nuksimon/Sequencer/README.md

Sequencer Wall Interactive Music Project
====

http://sequencedlife.wordpress.com/

a tactile music installation built with an arduino. 
step sequencer interface encourages music creation regardless of skill.
