nuksimon/Sequencer/Schematics/Sequencer Block Diagram.pptx

Ableton
(sound)

Arduino
(brains)

Sequencer
(lights & buttons)

LED Brightness

Audio
Processing

MIDI

State
Machine

LEDs
Buttons

Button Press

## Slide 2

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
