nuksimon/Sequencer/Design/UI Design.xlsx

Sheet: UI
 |  | Pages
 |  | 1 | 2 | 3 | 4 | 5 | 6 | 7 | 8
Channels | 1
 | 2
 | 3
 | 4 |  |  |  | Grid
 | 5
 | 6
 | 7
 | 8

Sheet: Grid
 |  | Page
 | Channel | 0 | 1 | 2 | 3 | 4 | 5 | 6 | 7
Instrument #1 | 0 | Inst.1 /p1 | Inst.1 /p2 | Inst.1 /p3 | Inst.1 /p4 | Inst.1 /p5 | Inst.1 /p6 | Inst.1 /p7 | Inst.1 /p8
Instrument #2 | 1 | Inst.2 /p1 | Inst.2 /p2 | Inst.2 /p3 | Inst.2 /p4 | Inst.2 /p5 | Inst.2 /p6 | Inst.2 /p7 | Inst.2 /p8
Instrument #3 | 2 | Inst.3 /p1 | Inst.3 /p2 | Inst.3 /p3 | Inst.3 /p4 | Inst.3 /p5 | Inst.3 /p6 | Inst.3 /p7 | Inst.3 /p8
Instrument #4 | 3 | Inst.4 /p1 | Inst.4 /p2 | Inst.4 /p3 | Inst.4 /p4 | Inst.4 /p5 | Inst.4 /p6 | Inst.4 /p7 | Inst.4 /p8
 | 4
Menu | 5 | Tempo | Steps | Prob |  |  |  |  | Clear
Freeze/Follow | 6 | Freeze/Follow
Play/Pause | 7 | Play/Pause
Function | Description
Instrument #1 | Sends Midi to Instrument#1
Instrument #2 | Sends Midi to Instrument#2
Instrument #3 | Sends Midi to Instrument#3
Instrument #4 | Sends Midi to Instrument#4
Tempo | Sets the global tempo, 1 to 64 (slow to fast)
Steps | Sets the number of steps to loop through on this sequencer, 1 to 64
Prob | Sets the probability of moving to a different sequencer, 1 to 8 (low to high chance)
Clear | Clears page/instrument/all instruments of what has been programmed
Freeze/Follow | Toggels the Grid to follow the current step as it switches between pages, or to remain stationary
Play/Pause | Global play/pause for the sequencers

Sheet: Arduino Elements
Element | < max | Description
seq_num | 3 | the physical sequencer board
col_num | 10 | button/RGB LED column number. Grid = 1-8, Channel = 0, Page = 9
row_num | 8 | button/RGB LED column number
rgb | 3 | identifies the Red, Green, or Blue element for the LEDs
channel_num | 8 | channel identifier (vertical menu)
page_num | 8 | page identifier (horizontal menu)
state_val | tbd | current state of the LED element
led_col | 16 | LED column number for a given row (i.e. each RGB LED requires 3 columns)
rgb_val | 4095 | 12 bit RGB brightness value for the LED
Array | Description
column_map | static mapping array to find the led_col
colour_map | static mapping array to find the rgb_val for an LED element
active_channel | channel currently being displayed on the specified sequencer
active_page | page currently being displayed on the specified sequencer
state_ctrl | contains the current state of the state machine
