nuksimon/Sequencer/Design/Design Alternatives Parts Pricing.xlsx

Sheet: Parts
 | Part Name | Part Number | Desc | Source | Qty req | Price | #/Price | Cost
 | Button Pad | COM-07835 | 4x4 grid | SparkFun | 5 | 8.96 | 1 | 44.8
 | PCB |  |  |  | 1 | 40 | 1 | 40
Individual RGB | LED Control | MAX7219 |  |  | 4 | 13 | 1 | 52 |  |  | 320 | 16
 | RGB LED | COM-09985 |  | SparkFun | 80 | 59.59 | 100 | 47.672
Mono LED | LED Control | MAX7219 |  |  | 2 | 13 | 1 | 26
 | LED |  |  | SparkFun | 80 | 2.95 | 25 | 9.44
Board RGB? | LED Control | MAX7219 |  |  | 2 | 13 | 1 | 26
 | RGB LED | COM-09985 |  | SparkFun | 80 | 59.59 | 100 | 47.672
8x8 boards
Arduino | Arduino Mega 2560 |  |  | Creatron | 1 | 56.29 | 1 | 56.29
Test | RGB LED Matrix | COM-00683 | 8x8 test matrix | SparkFun | 1 | 29.95 | 1 | 29.95
RGB string | LED Pixel 20mm x bundle of 20 |  |  | bliptronics | 64 | 40.05 | 20 | 128.16
 | no driver required
driver circuit | LED driver | TLC5940 | 16 channel | TI | 2 | 11 | 1 | 22
 | RGB LED |  | common ANODE | SparkFun | 64 | 59.59 | 100 | 38.1376
 | pnp transistor |  |  |  | 8 | 0.3 | 1 | 2.4
 | diodes |  |  |  | 64 | 3 | 10 | 19.2
 | Shift Reg S_to_P | 74HC595 | 8 bit row control |  | 2 | 1.05 | 1 | 2.1 | or 8 bit | 74HC595 |  | 16 bit | 74F673A
 | Shift Reg P_to_S | 74LS165 | 8 bit button col read |  | 2 | 1.2 | 1 | 2.4 | or 8 bit | 74LS165 |  | 16 bit | 74F676
 | Button Pad | COM-07835 | 4x4 grid, 3-5mm LEDs | SparkFun | 4 | 8.96 | 1 | 35.84
 | PCB |  |  |  | 1 | 40 | 1 | 40
 | IC Sockets |  |  |  | 4 | 1 | 1 | 4
 |  |  |  |  |  |  | Total | 162.0776
 | or 3 bit MUX?? | 74LS42 | 10 channel mux
Monome 4 8x8
Logic Board |  |  |  |  | 1 | 60 | 1 | 60
Driver |  |  |  |  | 4 | 40 | 1 | 160
Keypad |  |  |  |  | 4 | 120 | 1 | 480
LEDs |  |  |  |  | 256 | 0.2 | 1 | 51.2
 |  |  |  |  |  |  | Total | 751.2

Sheet: IO
 | Sequencer | multiplier | arduino
clock | 1 | 1 | 1
vcc | 1 | 1 | 1
gnd | 1 | 1 | 1
row control | 4 | 1 | 4
col control | 1 | 5 | 5
button | 1 | 5 | 5
Total | 9 |  | 17
