nuksimon/Sequencer/Schematics/Part List v2.xlsx

Sheet: IO
Component | # I/O ports
LED Driver | 5
button | 3
Vcc | 1
GND | 1
Total | 10

Sheet: BOM
Part Number | Description | Circuit | Schematic# | #/seq | # total | Extra | Req | Have | Need | digi key
R 500Ω | pull down | Button Control | R21-R100 | 80 | 240 | 20 | 260 | 300 | -40
 | 4x4 button Grid | Button Control | SW1-SW80 | 5 | 15 | 1 | 16 | 16 | 0
74HC165 | 8-bit parallel to serial | Button Control | U30-U39 | 10 | 30 | 2 | 32 | 10 | 22 | 0.41
 | DIP Socket 16 | Button Control | U30-U39 | 10 | 30 | 5 | 35 | 11 | 24
TLC5940 | LED Driver | LED Driver | U2-U17 | 16 | 48 | 2 | 50 | 5 | 45 | 3.6
 | DIP Socket 28 | LED Driver | U2-U17 | 16 | 48 | 5 | 53 | 10 | 43
R 2k | I regulator | LED Driver | R2-R17 | 16 | 48 | 5 | 53 |  | 53
 | DB15 | Connector, Arduino Breakout | J1 | 2 | 6 | 4 | 10 | 0 | 10 | 2.61
 | RGB LED - Common Anode | LED Array | L1-L80 | 80 | 240 | 60 | 300 | 300 | 0
?F | Regulator Caps |  | tbd |  | 0 | 5 | 5 | 0 | 5
R 220Ω | MIDI resistor | Arduino Breakout |  |  | 1 | 3 | 4 | 8 | -4
 | MIDI connectors | Arduino Breakout | J4, J5 |  | 2 | 0 | 2 | 2 | 0
 | DB15 Cable | Connector |  | 1 | 3 | 0 | 3 | 0 | 3 | 8
 | Arduino Mega2560 | Arduino |  |  | 1 | 0 | 1 | 1 | 0
 | External RAM | Arduino |  |  | 1 | 0 | 1 | 0 | 1
 | Sequencer PCB | PCB |  | 1 | 3 | 1 | 4 | 0 | 4

Sheet: SparkFun Order
Part Number | Description | Circuit | Schematic# | #/seq | # total | Have | Need | Extra | total | SF # | # units | price/units | total price | order#
 | DIP Socket 16 | Row Driver, Button Control | U1, U4-U5 | 3 | 9 | 0 | 9 | 2 | 11 | PRT-07938 | 1 | 0.45 | 4.95 | 11
TLC5940 | LED Driver | Column Driver | U2-U3 | 2 | 6 | 2 | 4 | 1 | 5 | COM-10136 | 1 | 5.95 | 29.75 | 5
 | DIP Socket 28 | Column Driver | U2-U3 | 2 | 6 | 0 | 6 | 4 | 10 | PRT-07942 | 1 | 0.86 | 8.6 | 10
 | 4x4 button Grid | Button Array | SW1-SW80 | 5 | 15 | 0 | 15 | 1 | 16 | COM-07835 | 1 | 8.96 | 143.36 | 16
74HC165 | 8-bit parallel to serial | Button Control | U4-U5 | 2 | 6 | 0 | 6 | 4 | 10 | COM-09519 | 1 | 1.45 | 14.5 | 10
 |  |  |  |  |  |  |  |  |  |  |  |  | 201.16
 | RGB LED - Common Anode | LED Array | L1-L80 | 80 | 240 | 0 | 240 | 10 | 250 | COM-10819 | 25 | 17.96 | 179.6
 |  |  |  |  |  |  |  | 60 | 300 | Parts Express 100@ $28 | 100 | 28.85 | 86.55 | 3
1N4148 | Diode | Button Array | D1-D80 | 80 | 240 | 0 | 240 | 10 | 250 | COM-08588 | 1 | 0.12 | 30
 |  |  |  |  |  |  |  | 10 | 250 | Parts Express 100@ $28 | 1 | 0.05 | 12.5 | 250
 |  |  |  |  |  |  |  |  |  |  |  |  | 99.05

Sheet: Digi Key Order
Part Number | Description | Circuit | Schematic# | #/seq | # total | Extra | Req | Have | Need | digi key
74HC165 | 8-bit parallel to serial | Button Control | U30-U39 | 10 | 30 | 5 | 35 | 10 | 25 | 0.41
 | DIP Socket 16 | Button Control | U30-U39 | 10 | 30 | 6 | 36 | 11 | 25 | 0.211
TLC5940 | LED Driver | LED Driver | U2-U17 | 16 | 48 | 2 | 50 | 5 | 45 | 3.6
 | DIP Socket 28 | LED Driver | U2-U17 | 16 | 48 | 5 | 53 | 10 | 43 | 0.447
R 2k | I regulator | LED Driver | R2-R17 | 16 | 48 | 5 | 53 |  | 53 | 0.041
 | DB15 | Connector, Arduino Breakout | J1 | 2 | 6 | 2 | 8 | 0 | 8 | 2.72
 | DB15 Cable | Connector |  | 1 | 3 | 0 | 3 | 0 | 3
