nuksimon/Sequencer/Casing/casing hardware.xlsx

Standoff
Digi-Key Part Number | Manufacturer Part Number | Manufacturer | Description | Quantity Available | Factory Stock | Unit Price (CAD) | @ qty | Minimum Quantity | Series | Type | Threaded/Unthreaded | Gender | Diameter - Outside | Thread/Screw/Hole Size | Between Board Height | Length - Overall | Features | Material | Plating | Color
25504K-ND | 25504 | Keystone Electronics | HEX STANDOFF M3 NYLON 18MM | 8120 | 600 | 0.65 | 0 | 1 | - | Hex Standoff | Threaded | Male, Female | 0.197" (5.00mm) Hex | M3 Thread | 0.709" (18.00mm) | 1.024" (26.00mm) | - | Nylon | - | Natural
24340K-ND | 24340 | Keystone Electronics | HEX STANDOFF M3 ALUMINUM 18MM | 135 | 1200 | 0.88 | 0 | 1 | - | Hex Standoff | Threaded | Male, Female | 0.197" (5.00mm) Hex | M3 Thread | 0.709" (18.00mm) | 1.024" (26.00mm) | - | Aluminum | Iridite | Natural
Digi-Key Part Number | Manufacturer Part Number | Manufacturer | Description | Quantity Available | Factory Stock | Unit Price (CAD) | @ qty | Minimum Quantity | Series | Type | Screw Head Type | Drive Type | Features | Thread Size | Head Diameter | Head Height | Length - Below Head | Length - Overall | Material | Plating
29346K-ND | 29346 | Keystone Electronics | MACHINE SCREW PAN SLOTTED M3 | 385 | 600 | 0.24 | 0 | 1 | - | Machine Screw | Pan Head | Slotted | - | M3 | - | - | 0.630" (16.00mm) | - | Nylon | -
29316K-ND | 29316 | Keystone Electronics | MACHINE SCREW PAN SLOTTED M3 | 468 | 900 | 0.48 | 0 | 1 | - | Machine Screw | Pan Head | Slotted | - | M3 | - | - | 0.630" (16.00mm) | - | Steel | Zinc
Item | #/board | all boards | extra | Total |  |  |  |  | 8.541
Standoff | 9 | 27 | 23 | 50 |  |  |  | 10 | 0.219 | 37.48858447
Screw | 9 | 27 | 23 | 50 |  |  |  | 50 | 0.1642 | 8.21
 |  |  |  |  |  |  |  | 10 | 0.505 | 5.05 | 39.98019802
 |  |  |  |  |  |  |  | 50 | 0.4038 | 20.19
