nuksimon/Sequencer/Design/Test Cases.xlsx

# | Result | PCB Pre-Req? | Test Case Name | Test Area | Description | Parameters
1 | Pass | Yes | Arduino->MIDI out | MIDI | Arduino can generate MIDI commands to serial output | Note On, Note Off, single channel
2 | Pass | Yes | Arduino->MIDI->Ableton out | MIDI | Ableton can receive MIDI commands generated by Arduino | Note On, Note Off, multiple channels
3 |  |  | Ableton->MIDI->Arduino in | MIDI | Arduino can receive MIDI commands generated by Ableton | Note On, Note Off, multiple channels
4 | Pass | Yes | Daisy Chain LED driver | LED | Send commands to daisy chained LED Drivers | 2 LED drivers
5 |  |  | Daisy Chain LED driver (full) | LED | Send commands to daisy chained LED Drivers | 16 LED drivers
6 |  | Yes | LED drivers on separate Seq | LED | Send commands to different LED Drivers in parallel (different output pins) | 2 LED drivers
7 |  |  | LED drivers on separate Seq (chained) | LED | Send commands to chained LED Drivers in parallel (different output pins) | 6 LED drivers (2 chained on 3 seq)
8 | Pass | Yes | Daisy Chain Buttons | Button | Read ouputs from daisy chained Buttons | 2 Button registers
9 |  |  | Daisy Chain Buttons (full) | Button | Read ouputs from daisy chained Buttons | 10 Button registers
10 |  | Yes | Buttons on separate Seq | Button | Read ouputs from different Buttons in parallel (different input pins) | 2 Button registers
11 |  | Yes | Buttons on separate Seq (chained) | Button | Read ouputs from chained Buttons in parallel (different input pins) | 6 Button registers (2 chained on 3 seq)
12 |  |  | Full Power (1 Seq) | Power | Power Supply can suppot the required current | 1 Seq, all LEDs on
13 |  |  | Full Power (3 Seq) | Power | Power Supply can suppot the required current | 3 Seq, all LEDs on
14 |  |  | Power integrity | Cable | Verify signal integrity over the cable length | 3 feet of cable
15 |  |  | B_SOUT integrity | Cable | Verify signal integrity over the cable length | 3 feet of cable
16 |  |  | B_CLK integrity | Cable | Verify signal integrity over the cable length | 3 feet of cable
17 |  |  | B_LD integrity | Cable | Verify signal integrity over the cable length | 3 feet of cable
18 |  | Yes | L_GSCLK integrity | Cable | Verify signal integrity over the cable length | 3 feet of cable
19 |  |  | L_BLANK integrity | Cable | Verify signal integrity over the cable length | 3 feet of cable
20 |  |  | L_XLAT integrity | Cable | Verify signal integrity over the cable length | 3 feet of cable
21 |  |  | L_SCLK integrity | Cable | Verify signal integrity over the cable length | 3 feet of cable
22 |  |  | L_SIN integrity | Cable | Verify signal integrity over the cable length | 3 feet of cable
23 |  |  | Parallel Signal integrity | Cable | Verify signal integrity over the cable length | 3 feet of cable
24 | Pass | Yes | Module Integration | Integration | Buttons, LEDs, MIDI | 2 chips chained
25 |  |  | Module Integration (full) | Integration | Buttons, LEDs, MIDI | 1 complete seq
26 |  |  | Sequencer Integration | Integration | Buttons, LEDs, MIDI | 3 complete seq
27 |  |  | Sequencer over Cable | Integration | Buttons, LEDs, MIDI | 3 complete seq + cable length
 |  |  | Memory | Arduino | Arduino can handle the full state array in RAM
