nuksimon/Sequencer/Arduino/Memory Usage.xlsx

Array | Data Type | Index |  |  |  |  | Total Bytes |  | Lookup | Value
column_map | byte | max_col | max_rgb |  |  |  |  |  | max_seq | 3
 | 1 | 10 | 3 |  |  |  | 30 |  | max_channel | 8
colour_map | short | max_seq | max_state_val | max_rgb |  |  |  |  | max_page | 8
 | 2 | 3 | 5 | 3 |  |  | 90 |  | max_row | 8
button_state | boolean | max_seq | max_row | max_col |  |  |  |  | max_col | 10
 | 1 | 3 | 8 | 10 |  |  | 240 |  | max_rgb | 3
state_ctrl | byte | max_seq | max_channel | max_page | max_row | max_col |  |  | max_state_val | 5
 | 1 | 3 | 8 | 8 | 8 | 10 | 15360 |  | byte | 1
active_channel | byte | max_seq |  |  |  |  |  |  | boolean | 1
 | 1 | 3 |  |  |  |  | 3 |  | short | 2
active_page | byte | max_seq
 | 1 | 3 |  |  |  |  | 3
misc variables | byte | #
 | 1 | 30 |  |  |  |  | 30
 |  |  |  |  |  |  | 15726 | Bytes Used
 |  |  | Arduino Mega2560 built-in RAM |  |  |  | 8000
 |  |  |  |  |  |  | -7726 | Bytes Available
 |  |  | External MegaRAM shield (auto-mapped) |  |  |  | 56000
 |  |  |  |  |  |  | 48274 | Bytes Available
