nuksimon/Sequencer/Schematics/pdf/Sequencer_PCB.pdf

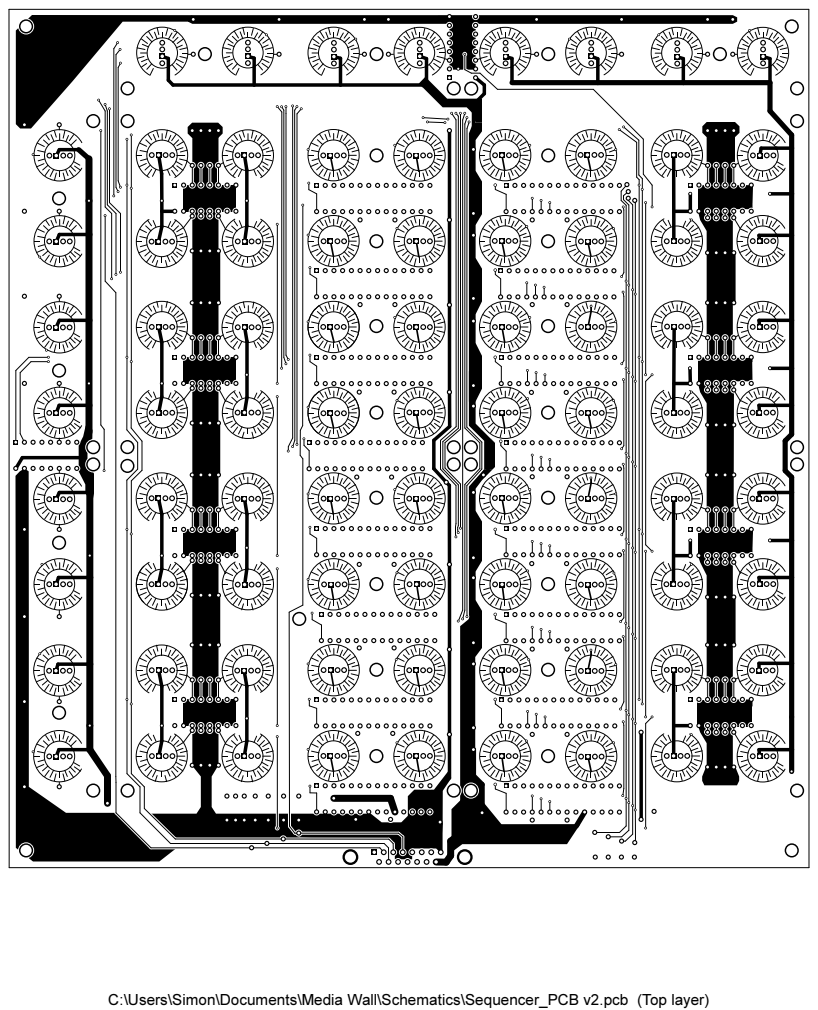
[picture p1: page 1]

C:\Users\Simon\Documents\Media Wall\Schematics\Sequencer_PCB v2.pcb (Top layer)

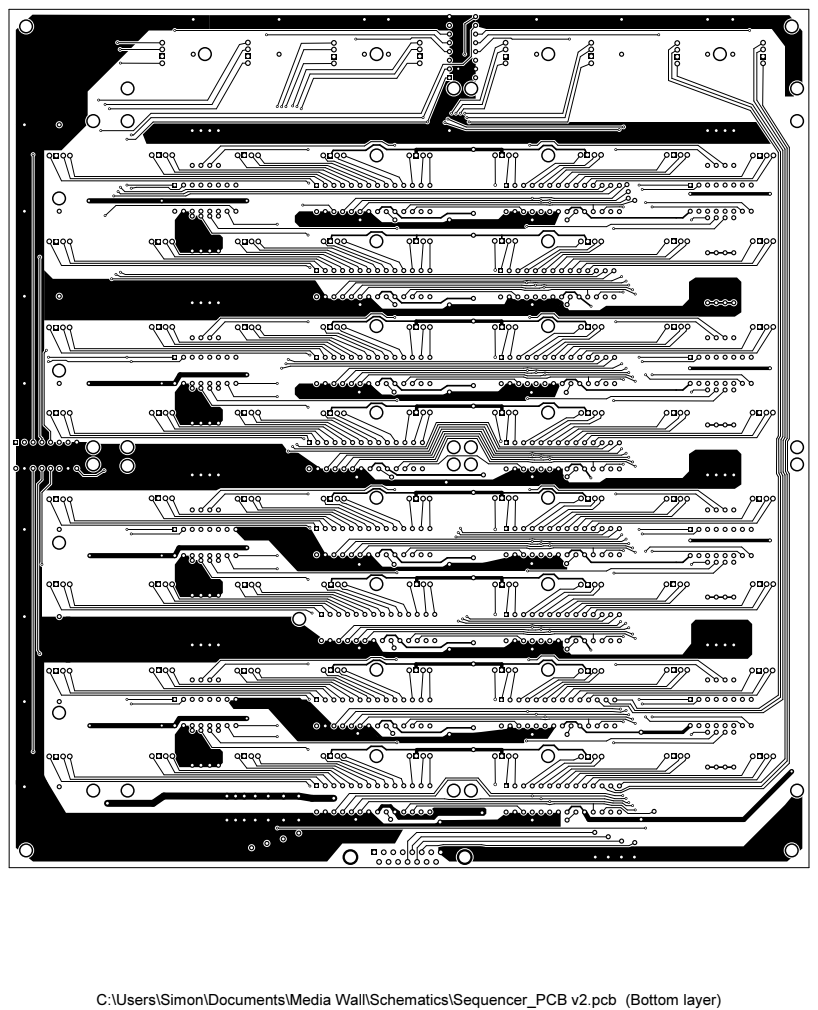
[picture p2: page 2]

C:\Users\Simon\Documents\Media Wall\Schematics\Sequencer_PCB v2.pcb (Bottom layer)

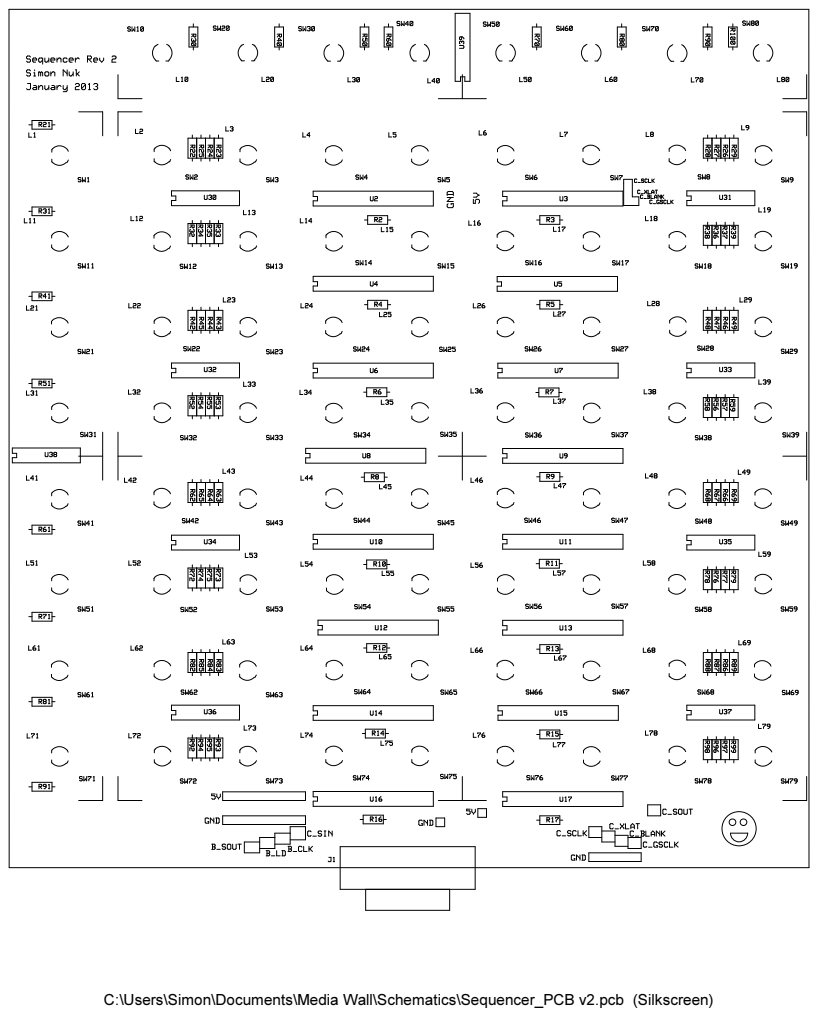
[picture p3: page 3]

C:\Users\Simon\Documents\Media Wall\Schematics\Sequencer_PCB v2.pcb (Silkscreen)

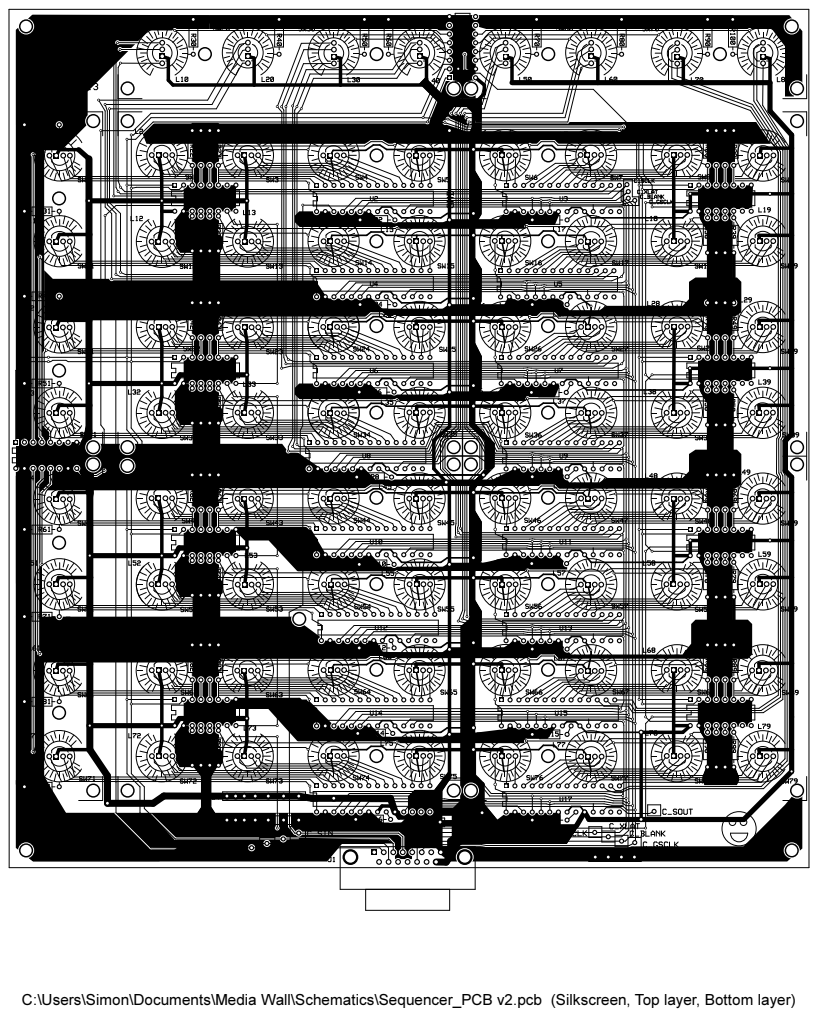
[picture p4: page 4]

C:\Users\Simon\Documents\Media Wall\Schematics\Sequencer_PCB v2.pcb (Silkscreen, Top layer, Bottom layer)
