nuksimon/Sequencer/Casing/Casing_Bottom_3.pdf

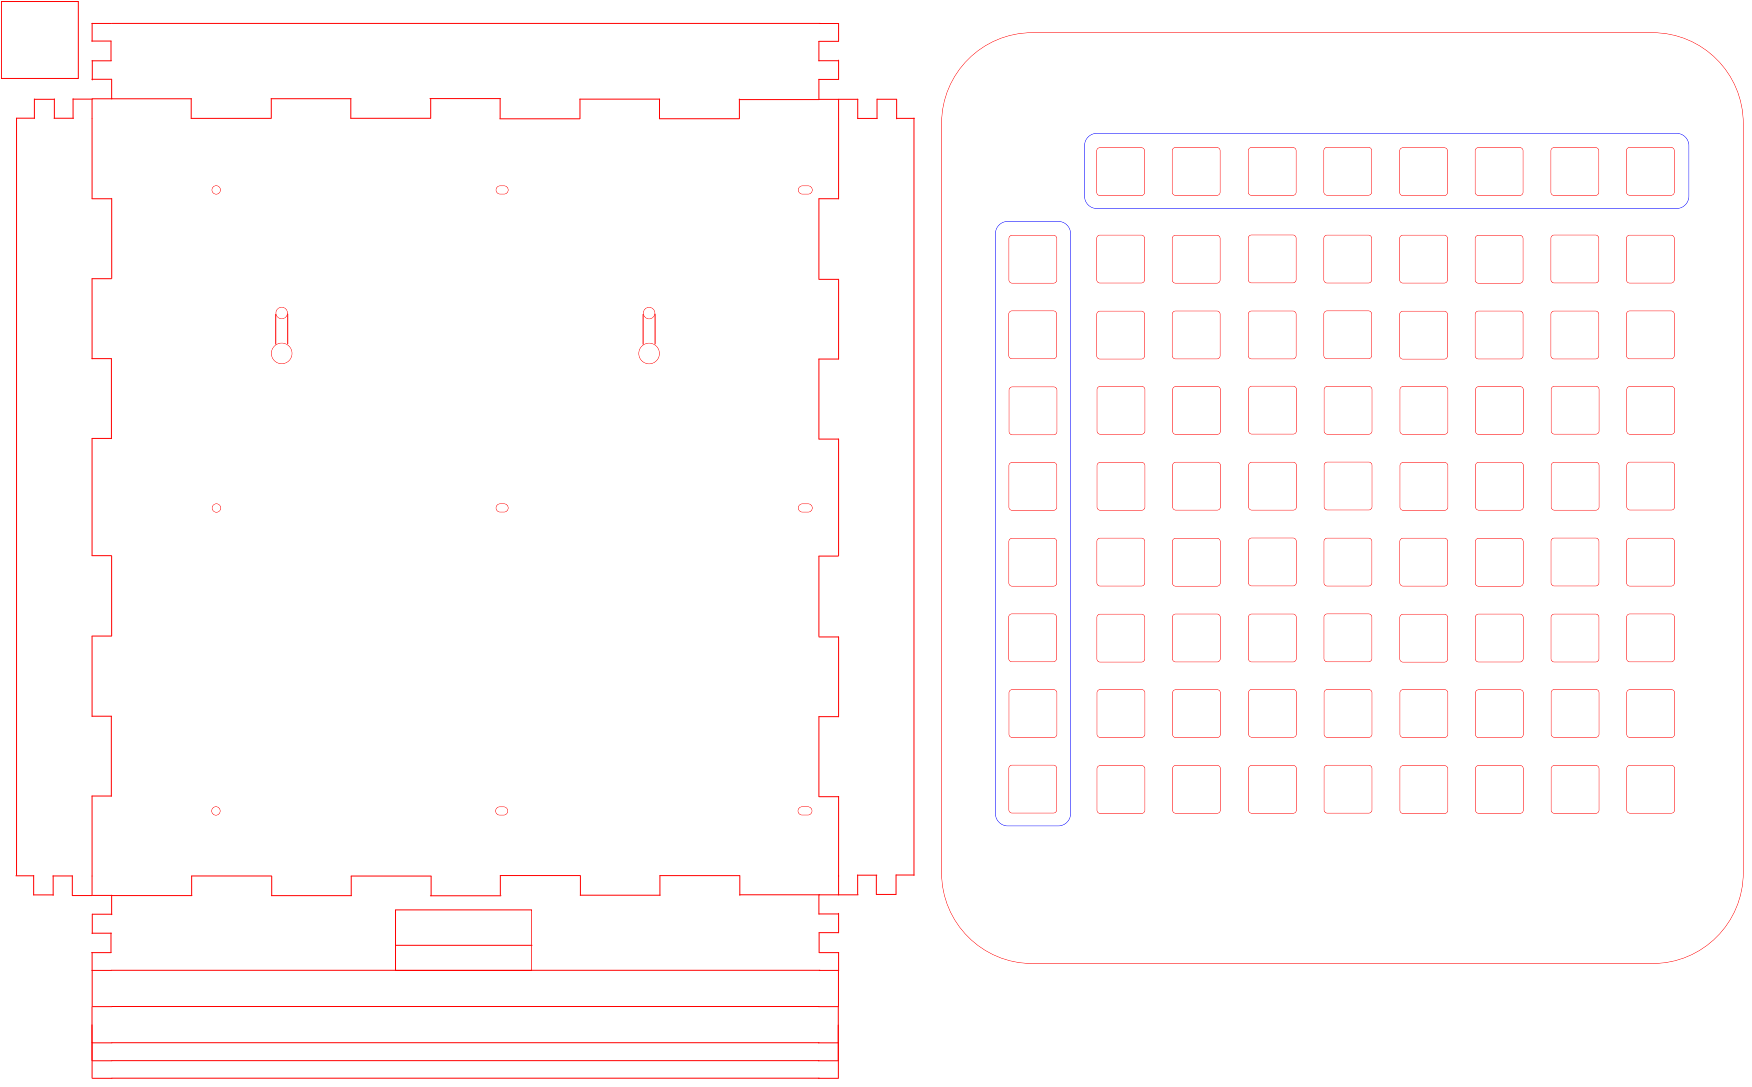
[picture p13: page 1]
