nuksimon/Sequencer/(list of files, drawings)

Other design files:
Fritzing/Arduino_Breakout.fzz
Schematics/Sequencer_PCB v2.pcb
