nuksimon/Sequencer/(commit log)

2013-10-20 changed LED colours
    [Sequencer Arduino Breakout.sch]
2014-03-24 Fritzing Arduino breakout
    [Arduino_Breakout.fzz]
2014-03-25 TLC5940
    driver for the tlc5940 chip
